jharveyb/BitVend/Arduino/pics/arduino_to_splice_wiring.jpg

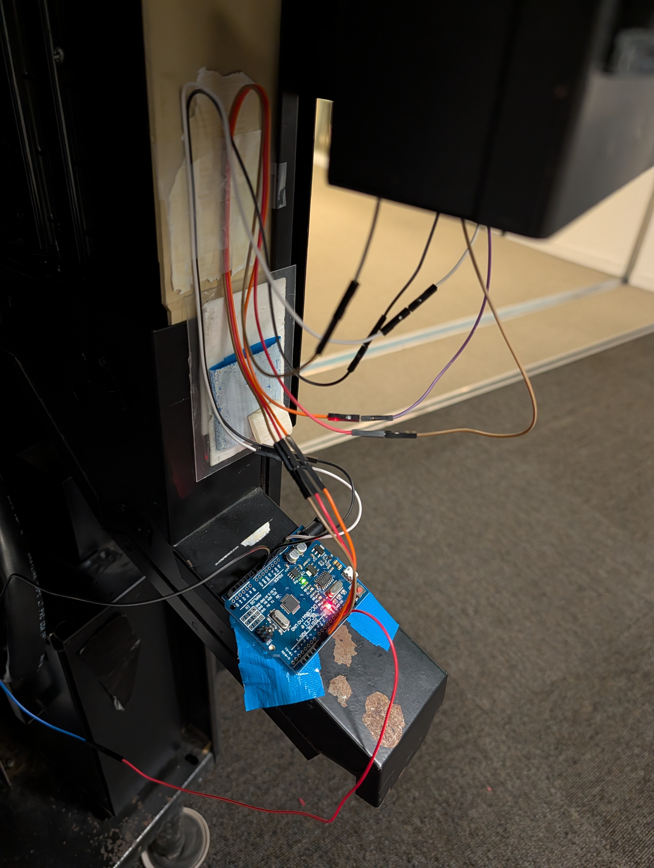
Arduino/pics/arduino_to_splice_wiring.jpg
