jharveyb/BitVend/Arduino/pics/coinmech_conrolboard_splice.jpg

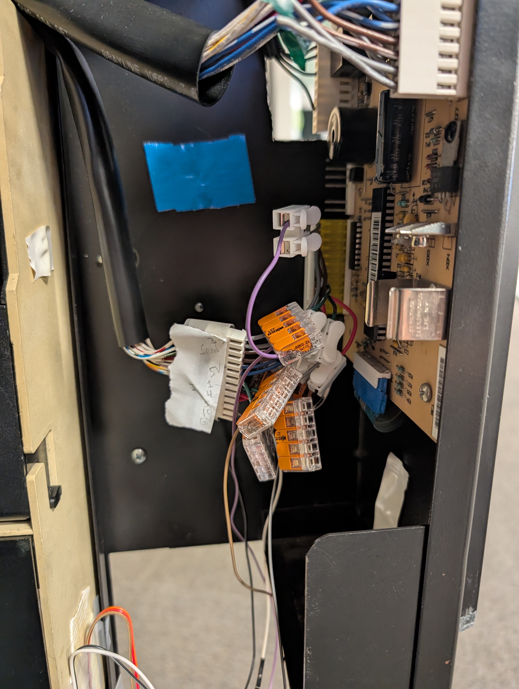
Arduino/pics/coinmech_conrolboard_splice.jpg
