jharveyb/BitVend/vendpost2.odt

Address will be refreshed regularly to preserve financial privacy. Updates forthcoming!

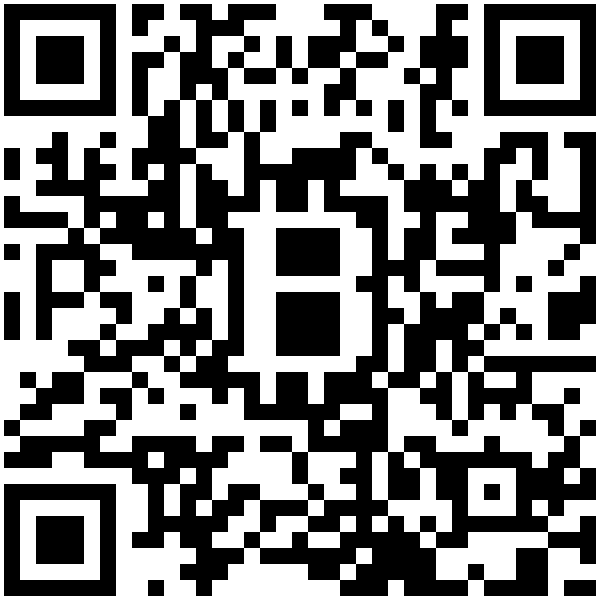
[picture p3: figure]

Pharmaceuticals in Row E are from nootrobox.com

Bugs? Requests for items? Email jharveyb@mit.edu

Many thanks to Tal, Jeremy, Joi, Jessica, & Kevin :)
