jharveyb/BitVend/vendpost.odt

Address will be refreshed regularly to preserve financial privacy. Updates forthcoming!

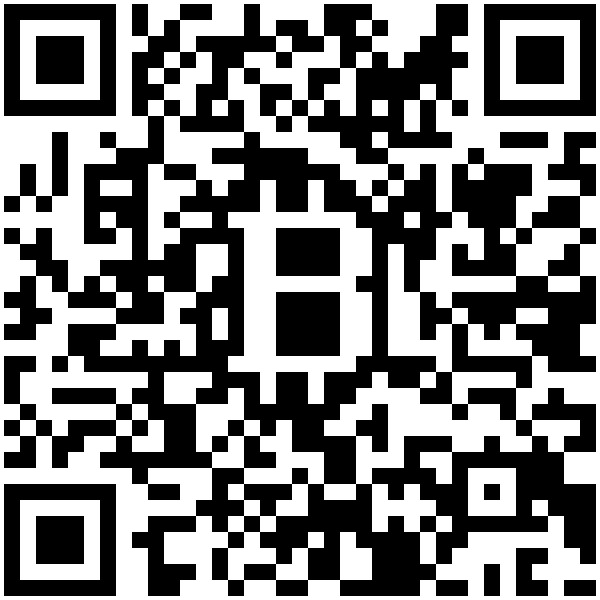
[picture p4: figure]

Bugs? Questions? Requests for items to stock? Email jharveyb@mit.edu

Many thanks to Tal, Jeremy, Joi, Jessica, & Kevin :)
