jharveyb/BitVend/Arduino/Arduino UNO Pinout Diagram.png

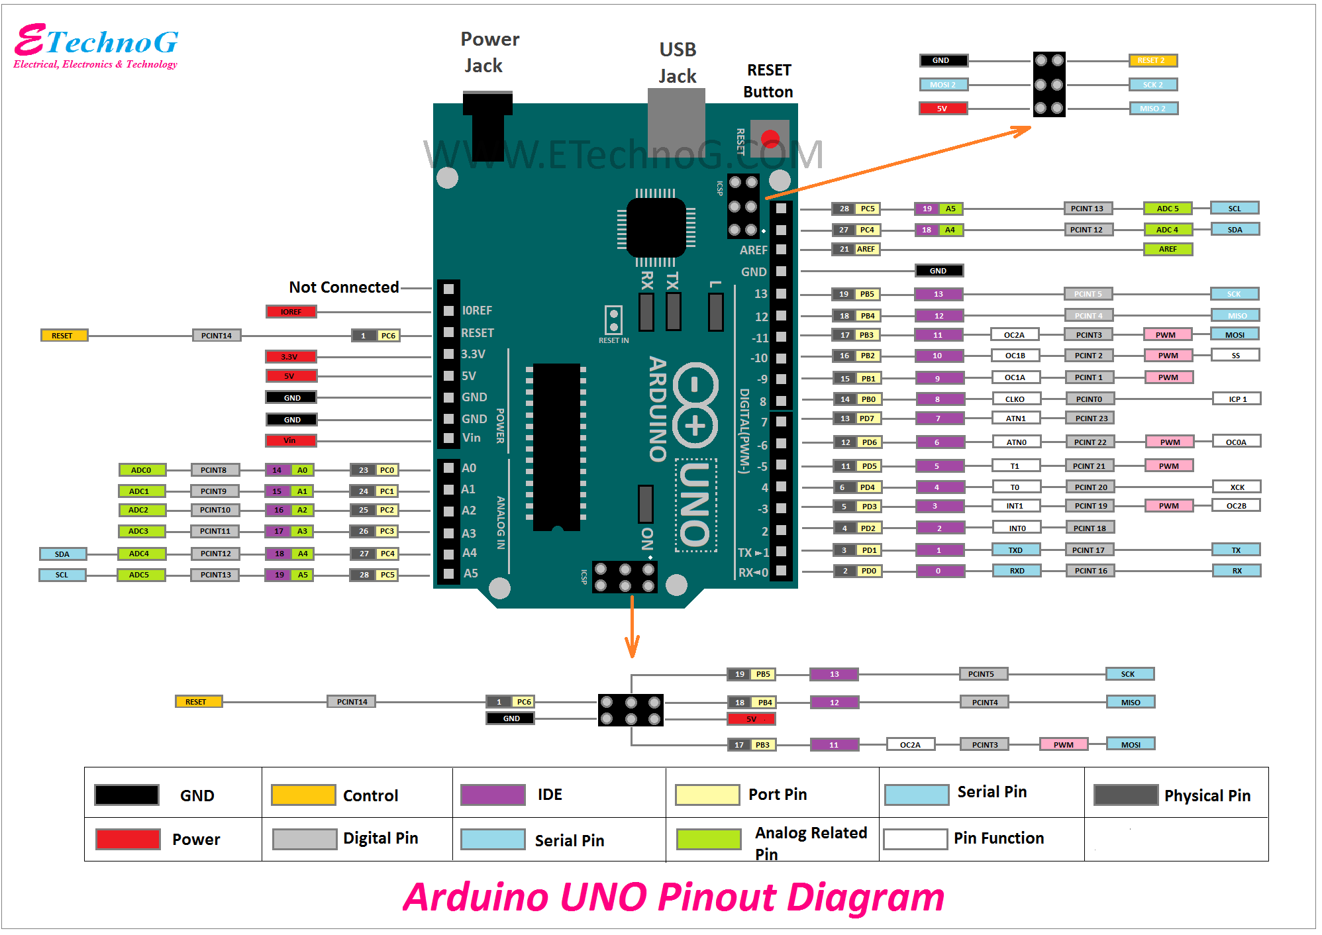
Arduino/Arduino UNO Pinout Diagram.png
