jharveyb/BitVend/Arduino/pics/pi_to_arduino_lines.jpg

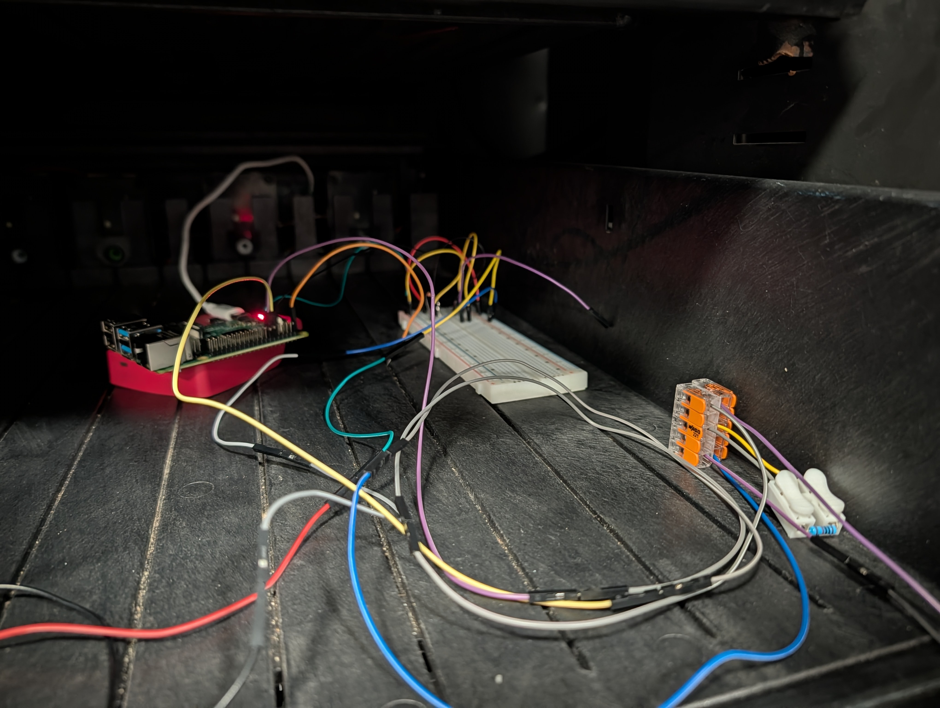
Arduino/pics/pi_to_arduino_lines.jpg
