jharveyb/BitVend/RPi/pi4_pinout.jpg

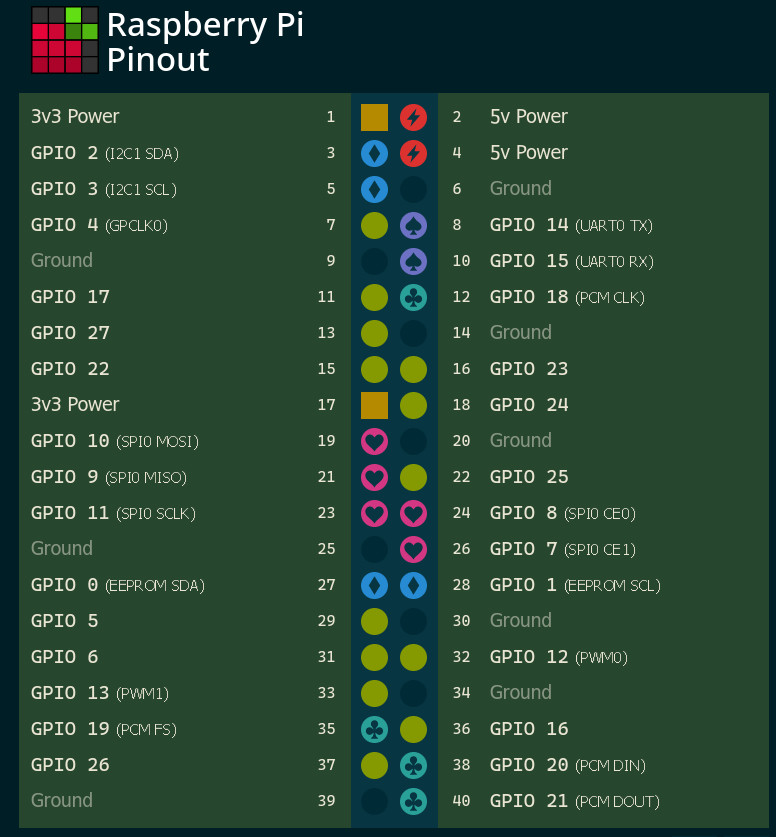
RPi/pi4_pinout.jpg
