jharveyb/BitVend/(commit log)

2016-07-20 Found Original Arduino code, big update to vend.py
2016-09-02 Recovered the Arduino code! And made post for new address.
2026-05-06 modernize Arduino tooling by adopting PlatformIO + adding code comments
2026-09-30 rpi: MVP of new payment acceptor service
    Use Lexe wallet with client credentials to receive LN payments.
    Pi is read-only, exactly-once payments, and handles price slippage.
    Tested on testnet and mainnet.
    GPIO timings and pin are configurable.
    [coin_signal.rs, lib.rs, live.rs, main.rs, price.rs, quarters.rs, vend.rs, vend_flow.rs]
2026-10-01 arduino: fix coinmech signalling
    The original build probably had some extra electronics, that ended up
    leaving the signal lines floating (so high) after a quarter replay.
    The existing code did not do that, which disables the real coinmech,
    and also breaks the quarter replay. This fixes that issue. Also,
    add a separate debug input pin for manual testing.
    [vend_hack.cpp]
2026-10-01 arduino: skip quarter 4 with unusually long signal
    [vend_hack.cpp]
2026-10-01 arduino: fix issue of micros() overflow
    This could cause a malformed quarter signal if sent during overflow.
    Which is expected every ~70 minutes.
    [main.rs, vend_hack.cpp]
2026-10-01 arduino: disable signal recording by default
2026-10-01 rpi: increase timing to not upset vend control board
    With the previous update speed, the vending machine
    control board was losing track of balance on the way to
    99 USD, and after overflow past 100 USD. This should help.
2026-10-01 arduino: organize legacy code, add wiring pics
